EminSarikaya/RC-CAR-PROJECT/Project Report - Proje Raporu/Proje Raporu (Türkçe).pdf

PROJE TEKNİK VE İŞLEVSEL REHBERİ:

KABLOSUZ TANK TİPİ 4X4 ROBOTİK PLATFORM

1. PROJENİN AMACI VE KİMLİĞİ: Bu proje, yüksek manevra kabiliyetine sahip, kablosuz kontrol edilebilen ve modüler bir robotik platform tasarlamak amacıyla geliştirilmiştir. Sistem, sadece bir oyuncak değil; zorlu zemin şartlarında hareket edebilen, kendi ekseni etrafında dönebilen ve kullanıcıya anlık bildirim sağlayan akıllı bir araçtır.

### 2. ARACIN TEMEL YETENEKLERİ VE İŞLEVLERİ: Bu bölüm, aracın fiziksel olarak

sahada neler yapabileceğini madde madde açıklamaktadır:

- Diferansiyel (Tank) Sürüş Kabiliyeti: Araç, tekerleklerini sağa sola çevirmeden, sağ ve sol motor gruplarının hız farkıyla yönlenir.
- Pivot (Sıfır Yarıçap) Dönüş: Olduğu yerde 360 derece dönebilir. Bu sayede kendi genişliğinden daha dar alanlarda bile manevra yaparak geri çıkabilir.
- Akıllı Motor Uyanma ve Hız Kontrolü: Yazılımsal "Uyanma Eşiği (Deadband Compensation)" sayesinde motorlar, mekanik sürtünmeleri anında aşarak kumanda tepkilerine sıfır gecikmeyle (lag olmadan) yanıt verir. Hassas joystick kontrolü sayesinde araç kademeli olarak hızlanır veya yavaşlar.
- Bağımsız Süspansiyon/Amortisör Kontrolü: Ön ve arka süspansiyon açıları, mekanik zorlanmaları engelleyen yazılımsal güvenlik limitleri (açı sınırı) dahilinde joystick üzerinden milimetrik olarak kontrol edilebilir.
- 9 Kanallı Akıllı Aydınlatma Sistemi: Araç üzerinde bulunan aydınlatmalar, kumanda üzerinden birçok kombinasyonda ve modda parlaklık ayarı yapılarak kontrol edilebilir. Amerikan Park ve Çakar (Strobe) modu gibi animasyonlar OLED menü ve 4x4 keypad üzerinden dinamik olarak yönetilir.
- "Ping-Pong" Akıllı Telemetri Sistemi: Araç, sürüş hissiyatında gecikme yaratmamak adına saniyede tam 1 kez "Rol Değiştirme (Role Switching)" taktiğiyle dinleme modundan çıkıp verici moduna geçer. Kumanda üzerindeki OLED ekran, aracın o anki durumunu (Özellikle dinamik araç bataryası ve sinyal seviyesini) kullanıcıya dijital olarak raporlar.
- Uzun Menzilli Kontrol: Harici antenli nRF24L01 modülleri sayesinde, aranızda engeller olsa bile (duvar, ağaç vb.) bağlantı kopmadan kontrol sağlanır.

### 3. DONANIM MİMARİSİ VE TEKNİK ALTYAPI: Sistemin bu yetenekleri sergilemesini

sağlayan teknolojik yapı taşları şunlardır:

- 3.1. Beyin: STM32 Mikrodenetleyici: Sistemin ana işlemcisi olan STM32, saniyede milyonlarca işlem yaparak kumandadan gelen sinyalleri milisaniyeler içinde motor komutlarına çevirir. 12-bitlik yüksek çözünürlüklü okuma kapasitesiyle, en ufak bir düğme hareketini bile algılar.

- 3.2. Kas Sistemi: TB6612FNG Yüksek Akım Motor Sürücü: Motorlara giden enerjiyi yönetir. Fırçalı DC motorların yüksek akım taleplerini karşılamak üzere breadboard üzerinden geçmeyen, doğrudan bataryaya bağlı kalın (15A) güç kablolarıyla desteklenmiştir. Bu mimari, voltaj çökmesini (brownout) ve işlemcinin kilitlenmesini engeller.
- 3.3. Sinir Sistemi: nRF24L01 ve "Klon-Savar" Mimari: Kablosuz haberleşmeyi sağlar. Piyasada bulunan klon nRF24 modüllerinin donanımsal çökme hatalarını aşmak için donanımsal ACK Payload yerine "Ping-Pong" stratejisi kullanılır. Uzak menzilli kullanım senaryolarında dahi kesintisiz iletişimi half-duplex modda sağlar.
- 3.4. Çevre Birimi Sürücüleri (ULN2003A): 9 farklı LED grubunun 7.4V sistemde mikrodenetleyici pinlerine zarar vermesini ve "gizli diyot kaçağı" (ghosting) yaşanmasını engellemek amacıyla ULN2003A darlington transistör entegresi kullanılır.

### 4. GÜÇ VE ENERJİ YÖNETİMİ: Araç ve kumanda, kararlı bir çalışma için iki farklı güç

stratejisi izler:

- Hassas Kontrol Hattı: İşlemciler ve antenler için LM2596 Voltaj Regülatörü kullanılır. Bu modül, pil voltajı düşse bile sistemi sabit 5V ile besleyerek haberleşmenin bozulmamasını sağlar. Araç bataryasının (7.4V) STM32 tarafından güvenle okunabilmesi için PB1 pininde 10k ve 4.7k'lık özel bir gerilim bölücü (Voltage Divider) devresi kullanılmıştır.
- Yüksek Güç Hattı: Motorlar, pilden doğrudan beslenir. Sony VTC6 (18650 Li-ion) yüksek deşarj kapasiteli bataryalar kullanılarak ani ivmelenmelerde sistemin ihtiyacı olan akım kusursuzca sağlanır. Bu ayrım, motorların yarattığı elektriksel gürültünün "beyni" karıştırmasını önler.

### 5. KONTROL MANTIĞI VE KULLANIM REHBERİ: Kumanda üzerindeki kontrol

birimleri şu şekilde bir görev paylaşımı yapar:

- Sürüş Joystickleri: Sağ ve sol joystickler aracın ileri/geri ve sağ/sol dönüşlerini milimetrik olarak yönetir. Tam sağa kırıldığında araç tanklar gibi kendi ekseninde dönmeye başlar.
- Amortisör Kontrolü: Sistem, butonlar aracılığıyla kilit açıldıktan sonra ön ve arka süspansiyonların yatay/dikey seviyelerini kontrol eder.
- Menü ve Aydınlatma Kontrolü (4x4 Keypad): 16 tuşlu keypad, OLED ekran üzerindeki menü sayfalarında gezinmeyi, aydınlatma modlarını (Çakar, Amerikan Park, vb.) ve parlaklık ayarlarını tek tıkla değiştirmeyi sağlar.

### 6. GÜVENLİK ÖZELLİKLERİ ("DEMİR KUBBE" FAILSAFE): Profesyonel bir

tasarımın en önemli parçası olan güvenlik önlemleri şunlardır:

- 300ms Otomatik Kilitlenme: Menzil dışına çıkıldığında veya kumanda pili bittiğinde, araç sinyal alamadığını fark eder ve motorları anında kilitler. Eşzamanlı olarak yön/süspansiyon servoları da güvenli merkez noktasına çekilir ve tüm aydınlatmalar söndürülür.
- Yazılımsal Akım Koruması: Ani tam gaz tepkilerinde işlemcinin kilitlenmemesi için yazılımsal hız limiti uygulanır. Motor sürücü, motorların zorlanması durumunda sistemi korumaya alarak kartın yanmasını önler.
- "Hayalet" ve Parazit Koruması: Motorlardan yansıyan parazitler, donanımsal filtreler (kondansatörler) ile temizlenir; böylece kumanda komutları her zaman net şekilde ulaşır. İletişim paketinin içerisine gömülen 0x55 güvenlik şifresi sayesinde havadaki hiçbir yabancı Wi-Fi veya Bluetooth sinyali aracın kontrolünü ele geçiremez.
