EminSarikaya/RC-CAR-PROJECT/Project Report - Proje Raporu/Project Report (English).pdf

PROJECT TECHNICAL AND FUNCTIONAL GUIDE:

WIRELESS TANK TYPE 4X4 ROBOTIC PLATFORM

### 1. PROJECT PURPOSE AND IDENTITY:

- This project was developed to design a highly maneuverable, wirelessly controllable, and modular robotic platform.
- The system is not just a toy; it is a smart vehicle capable of moving in harsh ground conditions, turning on its own axis, and providing instant feedback to the user.

### 2. CORE CAPABILITIES AND FUNCTIONS OF THE VEHICLE:

This section explains point by point what the vehicle can physically do in the field:

- Differential (Tank) Drive Capability: The vehicle is steered by the speed difference between the right and left motor groups, without turning its wheels left or right.
- Pivot (Zero Radius) Turn: It can rotate 360 degrees in place. This allows it to maneuver and back out even in spaces narrower than its own width.
- Smart Motor Wake-up and Speed Control: Thanks to the software-based "Deadband Compensation," the motors instantly overcome mechanical friction and respond to remote control inputs with zero latency (no lag). Precise joystick control allows the vehicle to accelerate or decelerate gradually.
- Independent Suspension/Shock Absorber Control: Front and rear suspension angles can be controlled with millimeter precision via the joystick, within software-defined safety limits (angle boundaries) that prevent mechanical strain.
- 9-Channel Smart Lighting System: The lighting on the vehicle can be controlled in various combinations and modes via the remote control by adjusting the brightness. Animations such as USDM marker lights (American Park) and Strobe modes are dynamically managed via the OLED menu and the 4x4 keypad.
- "Ping-Pong" Smart Telemetry System: To avoid causing any latency in the driving feel, the vehicle switches from listening mode to transmitter mode exactly once per second using a "Role Switching" tactic. The OLED screen on the remote control digitally reports the vehicle's current status (especially dynamic vehicle battery and signal level) to the user.
- Long-Range Control: Thanks to nRF24L01 modules with external antennas, control is maintained without losing connection even if there are obstacles (walls, trees, etc.) between you.

### 3. HARDWARE ARCHITECTURE AND TECHNICAL INFRASTRUCTURE:

The technological building blocks that enable the system to exhibit these capabilities are as follows:

- 3.1. Brain: ESP32 Microcontroller: The ESP32, which is the main processor of the system, translates signals coming from the remote control into motor commands within milliseconds by performing millions of operations per second. With its 12-bit high-resolution reading capacity, it detects even the slightest button movement.
- 3.2. Muscle System: TB6612FNG High Current Motor Driver: It manages the energy going to the motors. To meet the high current demands of brushed DC motors, it is supported by thick (15A) power cables connected directly to the battery, bypassing the breadboard. This architecture prevents voltage drop (brownout) and the processor from freezing.
- 3.3. Nerve System: nRF24L01 and "Clone-Repellent" Architecture: It provides wireless communication. To overcome the hardware crash errors of clone nRF24 modules available in the market, a "Ping-Pong" strategy is used instead of a hardware ACK Payload. It provides uninterrupted communication in half-duplex mode even in long-range usage scenarios.
- 3.4. Peripheral Drivers (ULN2003A): The ULN2003A Darlington transistor array is used to prevent 9 different LED groups from damaging the microcontroller pins in the 7.4V system and to avoid "ghosting" (hidden diode leakage).

### 4. POWER AND ENERGY MANAGEMENT:

The vehicle and the remote control follow two different power strategies for stable operation:

- Sensitive Control Line: An LM2596 Voltage Regulator is used for the processors and antennas. This module feeds the system with a constant 5V even if the battery voltage drops, ensuring that communication is not disrupted. A special voltage divider circuit with 10k and 4.7k resistors is used on the PB1 pin so that the vehicle battery (7.4V) can be safely read by the ESP32.
- High Power Line: The motors are powered directly from the battery. High-discharge capacity Sony VTC6 (18650 Li-ion) batteries are used to flawlessly provide the current required by the system during sudden accelerations. This separation prevents the electrical noise generated by the motors from confusing the "brain".

### 5. CONTROL LOGIC AND USER GUIDE:

The control units on the remote control share tasks as follows:

- Driving Joysticks: The right and left joysticks manage the vehicle's forward/backward and right/left turns with millimeter precision. When fully turned to the right, the vehicle starts to rotate on its own axis like tanks.
- Shock Absorber Control: After the lock is released via buttons, the system controls the horizontal/vertical levels of the front and rear suspensions.
- Menu and Lighting Control (4x4 Keypad): The 16-key keypad allows navigating the menu pages on the OLED screen, and changing lighting modes (Strobe, Marker Lights, etc.) and brightness settings with a single click.

### 6. SAFETY FEATURES ("IRON DOME" FAILSAFE):

The most important safety measures of a professional design are:

- 300ms Auto-Lock: When going out of range or when the remote control battery dies, the vehicle realizes it cannot receive a signal and instantly locks the motors. Simultaneously, the steering/suspension servos are pulled to a safe center point, and all lights are turned off.
- Software Current Protection: A software speed limit is applied to prevent the processor from freezing during sudden full-throttle responses. The motor driver protects the system and prevents the board from burning out if the motors are strained.
- "Ghost" and Interference Protection: Interference reflecting from the motors is cleaned with hardware filters (capacitors); thus, remote control commands always arrive clearly. Thanks to the 0x55 security password embedded in the communication packet, no foreign Wi-Fi or Bluetooth signal in the air can take control of the vehicle.
