EminSarikaya/RC-CAR-PROJECT/Pin Connections - Pin Bağlantıları/Controller Pin Connections (English).pdf

CONTROLLER UNIT CONNECTIONS:
A. OLED Screen (0.96" I2C)
- Pin 1: VCC → STM32 [3.3V]
- Pin 2: GND → General GND
- Pin 3: SCL → STM32 PB6
- Pin 4: SDA → STM32 PB7
B. nRF24L01 Communication Module
- Pin 1: VCC → 3.3V
- Pin 2: GND → General GND
- Pin 3: CE → STM32 PB0
- Pin 4: CSN → STM32 PA4
- Pin 5: SCK → STM32 PA5
- Pin 6: MISO → STM32 PA6
- Pin 7: MOSI → STM32 PA7
- Pin 8: IRQ → Empty
C. LEFT JOYSTICK (Throttle Control)
- Pin 1: GND → General GND
- Pin 2: +5V (VCC) → STM32 [3.3V]
- Pin 3: VRx (Horizontal) → Empty
- Pin 4: VRy (Vertical) → STM32 PA0
- Pin 5: SW (Button) → PB3
D. RIGHT JOYSTICK (Turning Control)
- Pin 1: GND → General GND
- Pin 2: +5V (VCC) → STM32 [3.3V]
- Pin 3: VRx (Horizontal) → STM32 PA1
- Pin 4: VRy (Vertical) → Empty
- Pin 5: SW (Button) → PB4

D. MIDDLE JOYSTICK (Servo Control)
- Pin 1: GND → General GND
- Pin 2: +5V (VCC) → STM32 [3.3V]
- Pin 3: VRx (Front Control) → STM32 PA2
- Pin 4: VRy (Real Control) → STM32 PA3
- Pin 5: SW (Button) → PB5
F. 4x4 KEYPAD
- Pin 1: (C4) → STM32 PB11
- Pin 2: (C3) → STM32 PB10
- Pin 3: (C2) → STM32 PB9
- Pin 4: (C1) → STM32 PB8
- Pin 5: (R1) → STM32 PB12
- Pin 6: (R2) → STM32 PB13
- Pin 7: (R3) → STM32 PB14
- Pin 8: (R4) → STM32 PB15
E. VOLTAGE DIVIDER CIRCUIT
- LM2596 OUT (+) [5V] → 10k ohm → PB1
- GND → 4.7k ohm → PB1
F. CAPACITOR USAGE
- GND → 100uF → 3.3V Line
G. FEED AND REGULATION
- LM2596 IN (+): 9V Battery Positive (+) Side
- LM2596 IN (-): 9V Battery Negative (-) Side
- LM2596 OUT (+): Only to parts which works with 5V and STM32 5V pin
- LM2596 OUT (-): General GND Line
