EminSarikaya/RC-CAR-PROJECT/Pin Connections - Pin Bağlantıları/Kumanda Pin Bağlantıları (Türkçe).pdf

KUMANDA ÜNİTESİ BAĞLANTILARI:

A. OLED Ekran (0.96" I2C)
- Pin 1: VCC → STM32 [3.3V]
- Pin 2: GND → Ortak GND
- Pin 3: SCL → STM32 PB6
- Pin 4: SDA → STM32 PB7
B. nRF24L01 Haberleşme Modülü
- Pin 1: VCC → 3.3V
- Pin 2: GND → Ortak GND
- Pin 3: CE → STM32 PB0
- Pin 4: CSN → STM32 PA4
- Pin 5: SCK → STM32 PA5
- Pin 6: MISO → STM32 PA6
- Pin 7: MOSI → STM32 PA7
- Pin 8: IRQ → Boşta
C. SOL JOYSTICK (Gaz Kontrolü)
- Pin 1: GND → Ortak GND
- Pin 2: +5V (VCC) → STM32 [3.3V]
- Pin 3: VRx (Yatay) → Boşta
- Pin 4: VRy (Dikey) → STM32 PA0
- Pin 5: SW (Buton) → PB3
D. SAĞ JOYSTICK (Yön Kontrolü)
- Pin 1: GND → Ortak GND
- Pin 2: +5V (VCC) → STM32 [3.3V]
- Pin 3: VRx (Yatay) → STM32 PA1
- Pin 4: VRy (Dikey) → Boşta
- Pin 5: SW (Buton) → PB4

D. ORTA JOYSTICK (Servo Kontrolü)
- Pin 1: GND → Ortak GND
- Pin 2: +5V (VCC) → STM32 [3.3V]
- Pin 3: VRx (Ön Kontrol) → STM32 PA2
- Pin 4: VRy (Arka Kontrol) → STM32 PA3
- Pin 5: SW (Buton) → PB5
F. 4x4 KEYPAD
- Pin 1: (C4) → STM32 PB11
- Pin 2: (C3) → STM32 PB10
- Pin 3: (C2) → STM32 PB9
- Pin 4: (C1) → STM32 PB8
- Pin 5: (R1) → STM32 PB12
- Pin 6: (R2) → STM32 PB13
- Pin 7: (R3) → STM32 PB14
- Pin 8: (R4) → STM32 PB15
E. GERİLİM BÖLÜCÜ DEVRESİ
- LM2596 OUT (+) [5V] → 10k ohm → PB1
- GND → 4.7k ohm → PB1
F. KAPASİTÖR KULLANIMI
- GND → 100uF → 3.3V HATTI
G. BESLEME VE REGÜLASYON
- LM2596 IN (+): 9V Pil Pozitif (+) Ucu
- LM2596 IN (-): 9V Pil Negatif (-) Ucu
- LM2596 OUT (+): Sadece 5V ile çalışan parçalara ve STM32 "5V" pinine.
- LM2596 OUT (-): Ortak GND hattına
