EminSarikaya/RC-CAR-PROJECT/RC Car Codes/projeAraba/Core/Src/main.c

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
/* Includes ------------------------------------------------------------------*/
#include "main.h"

/* USER CODE BEGIN Includes */
#include <stdlib.h>
#include "NRF24.h"
#include "NRF24_reg_addresses.h"
/* USER CODE END Includes */

ADC_HandleTypeDef hadc1;

IWDG_HandleTypeDef hiwdg;

SPI_HandleTypeDef hspi1;

TIM_HandleTypeDef htim1;
TIM_HandleTypeDef htim2;
TIM_HandleTypeDef htim3;
TIM_HandleTypeDef htim4;

/* USER CODE BEGIN PV */

//KUMANDA İLE AYNI PAKET YAPISINA SAHİP STRUCT KISMININ KODU:
typedef struct __attribute__((packed)) {
	uint8_t guvenlikKodu;      // 1 Byte
	int16_t ileriGeri;         // 2 Byte
	int16_t sagSol;            // 2 Byte
	int16_t onAmortisor;       // 2 Byte
	int16_t arkaAmortisor;     // 2 Byte
	uint8_t isikDurumlari[9];  // 9 Byte
	uint8_t isikParlaklik[9];  // 9 Byte
	uint8_t ekstraButonlar;    // 1 Byte
	uint8_t bosluk[4];         // 4 Byte
} KumandaVerisi;               //TOPLAM 32 Byte

//KUMANDADAN GELEN VERİLERİN KISMININ KODLARI:
KumandaVerisi gelenPaket;
uint8_t RxAddress[] = { 0xEE, 0xDD, 0xCC, 0xBB, 0xAA };
uint32_t sonSinyalZamani = 0;

typedef struct {
	float aracPili;
} TelemetriVerisi;

TelemetriVerisi gidenTelemetri;
uint8_t TxAddress[] = { 0xEE, 0xDD, 0xCC, 0xBB, 0xAA };

//SÜSPANSİYON HAFIZA DEĞİŞKENLERİ:
int pwmOnHafiza = 150;
int pwmArkaHafiza = 150;
/* USER CODE END PV */

void SystemClock_Config(void);
static void MX_GPIO_Init(void);
static void MX_SPI1_Init(void);
static void MX_TIM1_Init(void);
static void MX_TIM2_Init(void);
static void MX_TIM3_Init(void);
static void MX_TIM4_Init(void);
static void MX_IWDG_Init(void);
static void MX_ADC1_Init(void);
/**
 * @brief  The application entry point.
 * @retval int
 */
int main(void) {

	/* MCU Configuration--------------------------------------------------------*/

	/* Reset of all peripherals, Initializes the Flash interface and the Systick. */
	HAL_Init();

	/* Configure the system clock */
	SystemClock_Config();

	/* Initialize all configured peripherals */
	MX_GPIO_Init();
	MX_SPI1_Init();
	MX_TIM1_Init();
	MX_TIM2_Init();
	MX_TIM3_Init();
	MX_TIM4_Init();
	MX_IWDG_Init();
	MX_ADC1_Init();
	/* USER CODE BEGIN 2 */
	__HAL_AFIO_REMAP_SWJ_NOJTAG();

	//VERİ AKTARIMINDAN EMİN OLMAK İÇİN PC13 LEDİ BAŞLANGIÇTA SÖNDÜRÜLÜR:
	HAL_GPIO_WritePin(GPIOC, GPIO_PIN_13, GPIO_PIN_SET);

	//MOTORLAR İÇİN PWM'NİN BAŞLADIĞI KISMIN KODU:
	HAL_TIM_Base_Start(&htim1);
	HAL_TIM_PWM_Start(&htim1, TIM_CHANNEL_1);
	HAL_TIM_PWM_Start(&htim1, TIM_CHANNEL_2);

	HAL_TIM_Base_Start(&htim2);
	HAL_TIM_PWM_Start(&htim2, TIM_CHANNEL_1);
	HAL_TIM_PWM_Start(&htim2, TIM_CHANNEL_2);

	HAL_TIM_Base_Start_IT(&htim4);

	//NRF24 ALICI RX YAPILANDIRMALARININ YAPILDIĞI KISMIN KODU:
	HAL_GPIO_WritePin(GPIOA, GPIO_PIN_4, GPIO_PIN_SET);
	HAL_Delay(50);

	nrf24_init();
	nrf24_tx_pwr(_0dbm);
	nrf24_data_rate(_1mbps);
	nrf24_set_channel(78);
	nrf24_set_crc(en_crc, _1byte);
	nrf24_pipe_pld_size(0, sizeof(KumandaVerisi));
	nrf24_auto_ack_all(1);

	nrf24_open_rx_pipe(0, RxAddress);
	nrf24_listen();
	/* USER CODE END 2 */

	/* Infinite loop */
	/* USER CODE BEGIN WHILE */
	uint32_t sonTelemetriZamani = 0;

	while (1) {
		/* USER CODE END WHILE */

		/* USER CODE BEGIN 3 */

				//KUMANDADAN GELEN VERİLERİN DİNLENDİĞİ KISMIN KODLARI:
				if (nrf24_data_available()) {

					//NRF24'ÜN ANLIK DURUMUNU KONTROL EDEN DEĞİŞKEN:
					uint8_t nrfDurum = nrf24_r_status();

					//ÇİPİN MANTIKLI DEĞERLER ÜRETTİĞİ ZAMAN İŞLENDİĞİ KISIM:
					if (nrfDurum != 0x00 && nrfDurum != 0xFF) {

						nrf24_receive((uint8_t*) &gelenPaket, sizeof(KumandaVerisi));

						//GELEN PAKETİN GÜVENLİK KODU 0x55 İSE İŞLEME GİREN KISIM:
						if (gelenPaket.guvenlikKodu == 0x55) {

							sonSinyalZamani = HAL_GetTick();
							HAL_GPIO_TogglePin(GPIOC, GPIO_PIN_13);

							//DİFERANSİYEL SÜRÜŞ HESAPLAMASI:
							int16_t solMotorHiz = gelenPaket.ileriGeri + gelenPaket.sagSol;
							int16_t sagMotorHiz = gelenPaket.ileriGeri - gelenPaket.sagSol;

							//MOTOR UYANMA EŞİĞİ:
							int16_t uyanmaEsigi = 50;

							if(solMotorHiz > 0) solMotorHiz += uyanmaEsigi;
							else if(solMotorHiz < 0) solMotorHiz -= uyanmaEsigi;

							if(sagMotorHiz > 0) sagMotorHiz += uyanmaEsigi;
							else if(sagMotorHiz < 0) sagMotorHiz -= uyanmaEsigi;

							//HIZ SINIRI:
							int16_t hizSiniri=220;

							if (solMotorHiz > hizSiniri) solMotorHiz = hizSiniri;
							if (solMotorHiz < -hizSiniri) solMotorHiz = -hizSiniri;
							if (sagMotorHiz > hizSiniri) sagMotorHiz = hizSiniri;
							if (sagMotorHiz < -hizSiniri) sagMotorHiz = -hizSiniri;

							//SOL MOTOR:
							if (solMotorHiz > 0) {
								HAL_GPIO_WritePin(GPIOB, MOTOR_SOL_ILERI_Pin, GPIO_PIN_SET);
								HAL_GPIO_WritePin(GPIOB, MOTOR_SOL_GERI_Pin, GPIO_PIN_RESET);
								__HAL_TIM_SET_COMPARE(&htim1, TIM_CHANNEL_1, solMotorHiz);
							} else if (solMotorHiz < 0) {
								HAL_GPIO_WritePin(GPIOB, MOTOR_SOL_ILERI_Pin, GPIO_PIN_RESET);
								HAL_GPIO_WritePin(GPIOB, MOTOR_SOL_GERI_Pin, GPIO_PIN_SET);
								__HAL_TIM_SET_COMPARE(&htim1, TIM_CHANNEL_1, -solMotorHiz);
							} else {
								HAL_GPIO_WritePin(GPIOB, MOTOR_SOL_ILERI_Pin, GPIO_PIN_RESET);
								HAL_GPIO_WritePin(GPIOB, MOTOR_SOL_GERI_Pin, GPIO_PIN_RESET);
								__HAL_TIM_SET_COMPARE(&htim1, TIM_CHANNEL_1, 0);
							}

							//SAĞ MOTOR:
							if (sagMotorHiz > 0) {
								HAL_GPIO_WritePin(GPIOB, MOTOR_SAG_ILERI_Pin, GPIO_PIN_SET);
								HAL_GPIO_WritePin(GPIOB, MOTOR_SAG_GERI_Pin, GPIO_PIN_RESET);
								__HAL_TIM_SET_COMPARE(&htim1, TIM_CHANNEL_2, sagMotorHiz);
							} else if (sagMotorHiz < 0) {
								HAL_GPIO_WritePin(GPIOB, MOTOR_SAG_ILERI_Pin, GPIO_PIN_RESET);
								HAL_GPIO_WritePin(GPIOB, MOTOR_SAG_GERI_Pin, GPIO_PIN_SET);
								__HAL_TIM_SET_COMPARE(&htim1, TIM_CHANNEL_2, -sagMotorHiz);
							} else {
								HAL_GPIO_WritePin(GPIOB, MOTOR_SAG_ILERI_Pin, GPIO_PIN_RESET);
								HAL_GPIO_WritePin(GPIOB, MOTOR_SAG_GERI_Pin, GPIO_PIN_RESET);
								__HAL_TIM_SET_COMPARE(&htim1, TIM_CHANNEL_2, 0);
							}
						}
					}
				}

				//ARAÇ PİLİNİN VOLTAJ DEĞERİNİN SANİYEDE 1 KERE OLMAK ÜZERE GÖNDERİLDİĞİ KISMIN KODLARI:

				if ((HAL_GetTick() - sonTelemetriZamani) > 1000) {

					//PİL DEĞERİNİN OKUNDUĞU KISMIN KODLARI:
					HAL_ADC_Start(&hadc1);
					if (HAL_ADC_PollForConversion(&hadc1, 5) == HAL_OK) {
						uint32_t adc_deger = HAL_ADC_GetValue(&hadc1);
						gidenTelemetri.aracPili = (adc_deger * 3.3f * (14.7f / 4.7f)) / 4095.0f;

						//HABERLEŞME MODUNUN DEĞİŞTİRİLİP ALICI MODDAN VERİCİ MODA GEÇİLDİĞİ KISMIN KODLARI:
						nrf24_stop_listen();
						nrf24_pipe_pld_size(0, sizeof(TelemetriVerisi));
						nrf24_open_tx_pipe(RxAddress);

						//PİL VOLTAJ DEĞERİNİN GÖNDERİLDİĞİ KISMIN KODU:
						nrf24_transmit((uint8_t*)&gidenTelemetri, sizeof(TelemetriVerisi));

						//PİL DEĞERİ GÖNDERİLDİKTEN SONRA HIZLICA TEKRARDAN ALICI MODA GEÇİLEN KISMIN KODLARI:
						nrf24_pipe_pld_size(0, sizeof(KumandaVerisi));
						nrf24_open_rx_pipe(0, RxAddress);
						nrf24_listen();
					}
					sonTelemetriZamani = HAL_GetTick();
				}

				//İLETİŞİM KESİLDİĞİ VAKİT KORUMA MODUNA GEÇİLEN KISMIN KODLARI:
				if ((HAL_GetTick() - sonSinyalZamani) > 300) {
					__HAL_TIM_SET_COMPARE(&htim1, TIM_CHANNEL_1, 0);
					__HAL_TIM_SET_COMPARE(&htim1, TIM_CHANNEL_2, 0);
					HAL_GPIO_WritePin(GPIOB,
							MOTOR_SOL_ILERI_Pin | MOTOR_SOL_GERI_Pin
									| MOTOR_SAG_ILERI_Pin | MOTOR_SAG_GERI_Pin,
							GPIO_PIN_RESET);
					HAL_GPIO_WritePin(GPIOC, GPIO_PIN_13, GPIO_PIN_SET);

					for (int i = 0; i < 9; i++) {
						gelenPaket.isikDurumlari[i] = 0;
					}

					pwmOnHafiza = 150;
					pwmArkaHafiza = 150;
					__HAL_TIM_SET_COMPARE(&htim2, TIM_CHANNEL_1, pwmOnHafiza);
					__HAL_TIM_SET_COMPARE(&htim2, TIM_CHANNEL_2, pwmArkaHafiza);
				}

				//SERVO KONTROLLERİNİN YAPILDIĞI KISMIN KODLARI:
				uint8_t amortisorKilitAcik = (gelenPaket.ekstraButonlar & (1 << 2));
				uint8_t amortisorAciSiniri = 20;

				if (amortisorKilitAcik) {
					pwmOnHafiza = 150 + ((gelenPaket.onAmortisor * amortisorAciSiniri) / 255);
					pwmArkaHafiza = 150 + ((gelenPaket.arkaAmortisor * amortisorAciSiniri) / 255);

					if (pwmOnHafiza > 150+amortisorAciSiniri) pwmOnHafiza = 150+amortisorAciSiniri;
					if (pwmOnHafiza < 150-amortisorAciSiniri) pwmOnHafiza = 150-amortisorAciSiniri;
					if (pwmArkaHafiza > 150+amortisorAciSiniri) pwmArkaHafiza = 150+amortisorAciSiniri;
					if (pwmArkaHafiza < 150-amortisorAciSiniri) pwmArkaHafiza = 150-amortisorAciSiniri;
				}

				__HAL_TIM_SET_COMPARE(&htim2, TIM_CHANNEL_1, pwmOnHafiza);
				__HAL_TIM_SET_COMPARE(&htim2, TIM_CHANNEL_2, pwmArkaHafiza);

				HAL_Delay(10);
				HAL_IWDG_Refresh(&hiwdg);

	}
	/* USER CODE END 3 */
}

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
/* USER CODE BEGIN 4 */
void HAL_TIM_PeriodElapsedCallback(TIM_HandleTypeDef *htim) {
	if (htim->Instance == TIM4) {
		static uint8_t pwmSayaci = 0;
		pwmSayaci++;

		//SİNYAL BLİNK PERİYODUNUN BELİRLENDİĞİ KISIM:
		uint8_t sinyalBlink = (HAL_GetTick() / 400) % 2;

		//KUMANDADAN GELEN AMERİKAN PARK BİLGİSİ KISMI:
		uint8_t amerikanParkAcik = (gelenPaket.ekstraButonlar & (1 << 4));

		//ÖN FAR KISMININ KODU:
		if(gelenPaket.isikDurumlari[0] && (pwmSayaci < gelenPaket.isikParlaklik[0]))
			HAL_GPIO_WritePin(ON_FAR_GPIO_Port, ON_FAR_Pin, GPIO_PIN_SET);
		else
			HAL_GPIO_WritePin(ON_FAR_GPIO_Port, ON_FAR_Pin, GPIO_PIN_RESET);

		//ÖN SİS KISMININ KODU:
		if (gelenPaket.isikDurumlari[1]
				&& (pwmSayaci < gelenPaket.isikParlaklik[1]))
			HAL_GPIO_WritePin(GPIOB, ON_SIS_Pin, GPIO_PIN_SET);
		else
			HAL_GPIO_WritePin(GPIOB, ON_SIS_Pin, GPIO_PIN_RESET);

		//SAĞ SİNYAL KISMININ KODU:
		uint8_t sagLedDurumu = 0;
		if (gelenPaket.isikDurumlari[2]) {
			sagLedDurumu = sinyalBlink;
		}                          // Sinyal butonu açıksa amerikan parklara nazaran önceliklidir.
		else if (amerikanParkAcik)
			sagLedDurumu = 1;      // Sinyal yok ama amerikan parklar açıksa sabit yanar.

		if (sagLedDurumu && (pwmSayaci < gelenPaket.isikParlaklik[2]))
			HAL_GPIO_WritePin(GPIOA, SAG_SINYAL_Pin, GPIO_PIN_SET);
		else
			HAL_GPIO_WritePin(GPIOA, SAG_SINYAL_Pin, GPIO_PIN_RESET);

		//SOL SİNYAL KISMININ KODU:
		uint8_t solLedDurumu = 0;
		if (gelenPaket.isikDurumlari[3]) {
			solLedDurumu = sinyalBlink;
		}                          // Sinyal butonu açıksa amerikan parklara nazaran önceliklidir.
		else if (amerikanParkAcik)
			solLedDurumu = 1;      // Sinyal yok ama amerikan parklar açıksa sabit yanar.

		if (solLedDurumu && (pwmSayaci < gelenPaket.isikParlaklik[3]))
			HAL_GPIO_WritePin(GPIOA, SOL_SINYAL_Pin, GPIO_PIN_SET);
		else
			HAL_GPIO_WritePin(GPIOA, SOL_SINYAL_Pin, GPIO_PIN_RESET);

		//İÇ AMBİYANS KISMININ KODU:
		if (gelenPaket.isikDurumlari[4]
				&& (pwmSayaci < gelenPaket.isikParlaklik[4]))
			HAL_GPIO_WritePin(GPIOB, IC_AMBIYANS_Pin, GPIO_PIN_SET);
		else
			HAL_GPIO_WritePin(GPIOB, IC_AMBIYANS_Pin, GPIO_PIN_RESET);

		//BAGAJ AMBİYANS KISMININ KODU:
		if (gelenPaket.isikDurumlari[5]
				&& (pwmSayaci < gelenPaket.isikParlaklik[5]))
			HAL_GPIO_WritePin(GPIOB, BAGAJ_AMBIYANS_Pin, GPIO_PIN_SET);
		else
			HAL_GPIO_WritePin(GPIOB, BAGAJ_AMBIYANS_Pin, GPIO_PIN_RESET);

		//ARKA STOP KISMININ KODU:
		if (gelenPaket.isikDurumlari[6]
				&& (pwmSayaci < gelenPaket.isikParlaklik[6]))
			HAL_GPIO_WritePin(GPIOB, ARKA_STOP_Pin, GPIO_PIN_SET);
		else
			HAL_GPIO_WritePin(GPIOB, ARKA_STOP_Pin, GPIO_PIN_RESET);

		//ARAÇ ALTI AYDINLATMA KISMININ KODU:
		if (gelenPaket.isikDurumlari[7]
				&& (pwmSayaci < gelenPaket.isikParlaklik[7]))
			HAL_GPIO_WritePin(GPIOB, ARAC_ALTI_Pin, GPIO_PIN_SET);
		else
			HAL_GPIO_WritePin(GPIOB, ARAC_ALTI_Pin, GPIO_PIN_RESET);

		//GERİ VİTES KISMININ KODU:
		if (gelenPaket.isikDurumlari[8]
				&& (pwmSayaci < gelenPaket.isikParlaklik[8]))
			HAL_GPIO_WritePin(GPIOB, GERI_VITES_Pin, GPIO_PIN_SET);
		else
			HAL_GPIO_WritePin(GPIOB, GERI_VITES_Pin, GPIO_PIN_RESET);
	}
}
/* USER CODE END 4 */
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
