EminSarikaya/RC-CAR-PROJECT/RC Car Codes/projeAraba/Core/Inc/main.h

#define SAG_SINYAL_Pin GPIO_PIN_2
#define SAG_SINYAL_GPIO_Port GPIOA
#define SOL_SINYAL_Pin GPIO_PIN_3
#define SOL_SINYAL_GPIO_Port GPIOA
#define GERI_VITES_Pin GPIO_PIN_10
#define GERI_VITES_GPIO_Port GPIOB
#define ON_SIS_Pin GPIO_PIN_11
#define ON_SIS_GPIO_Port GPIOB
#define MOTOR_SOL_ILERI_Pin GPIO_PIN_12
#define MOTOR_SOL_ILERI_GPIO_Port GPIOB
#define MOTOR_SOL_GERI_Pin GPIO_PIN_13
#define MOTOR_SOL_GERI_GPIO_Port GPIOB
#define MOTOR_SAG_ILERI_Pin GPIO_PIN_14
#define MOTOR_SAG_ILERI_GPIO_Port GPIOB
#define MOTOR_SAG_GERI_Pin GPIO_PIN_15
#define MOTOR_SAG_GERI_GPIO_Port GPIOB
#define MOTOR_SOL_HIZ_Pin GPIO_PIN_8
#define MOTOR_SOL_HIZ_GPIO_Port GPIOA
#define MOTOR_SAG_HIZ_Pin GPIO_PIN_9
#define MOTOR_SAG_HIZ_GPIO_Port GPIOA
#define ON_FAR_Pin GPIO_PIN_10
#define ON_FAR_GPIO_Port GPIOA
#define ARKA_STOP_Pin GPIO_PIN_4
#define ARKA_STOP_GPIO_Port GPIOB
#define IC_AMBIYANS_Pin GPIO_PIN_5
#define IC_AMBIYANS_GPIO_Port GPIOB
#define BAGAJ_AMBIYANS_Pin GPIO_PIN_6
#define BAGAJ_AMBIYANS_GPIO_Port GPIOB
#define ARAC_ALTI_Pin GPIO_PIN_7
#define ARAC_ALTI_GPIO_Port GPIOB
